jimhar8/WeatherMat/hardware/documentation/weatherSystem_blockDiagram.pdf

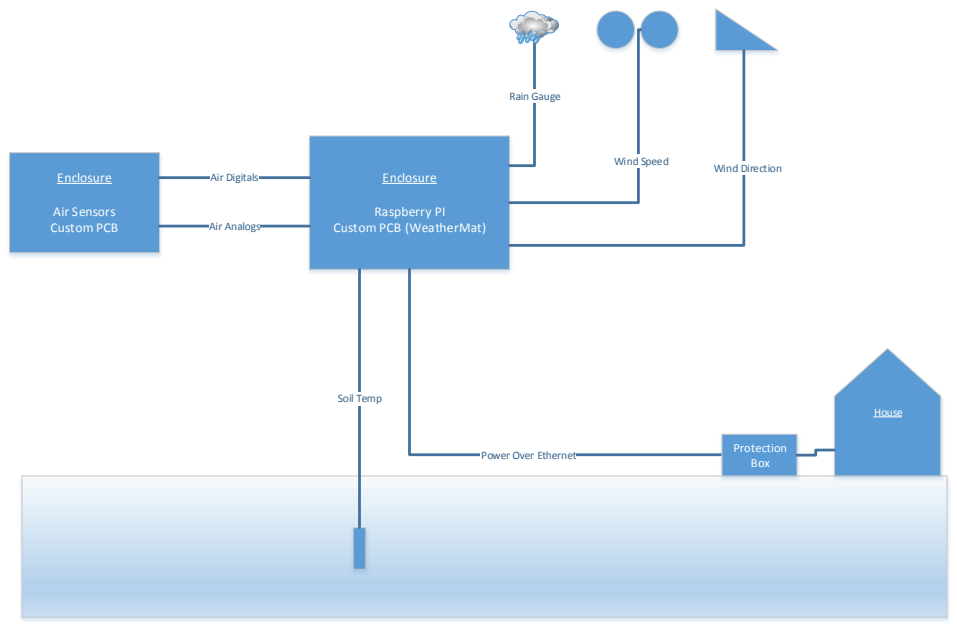
[picture p1: page 1]
Enclosure; Air Sensors Custom PCB; Air Digitals; Air Analogs; Wind Speed; Wind Direction; Soil Temp; Rain Gauge; House; Power Over Ethernet; Protection; Box

Raspberry PI
Custom PCB (WeatherMat)
