jimhar8/WeatherMat/hardware/documentation/airBoard_parts_top.pdf

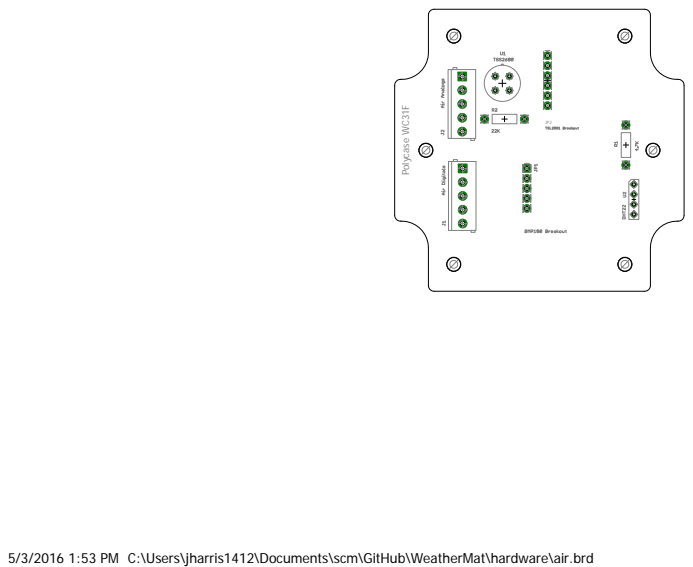
[picture p2: page 1]
Polycase WC31F

5/3/2016 1:53 PM C:\Users\jharris1412\Documents\scm\GitHub\WeatherMat\hardware\air.brd
