jimhar8/WeatherMat/hardware/documentation/airBoard_schematic.pdf

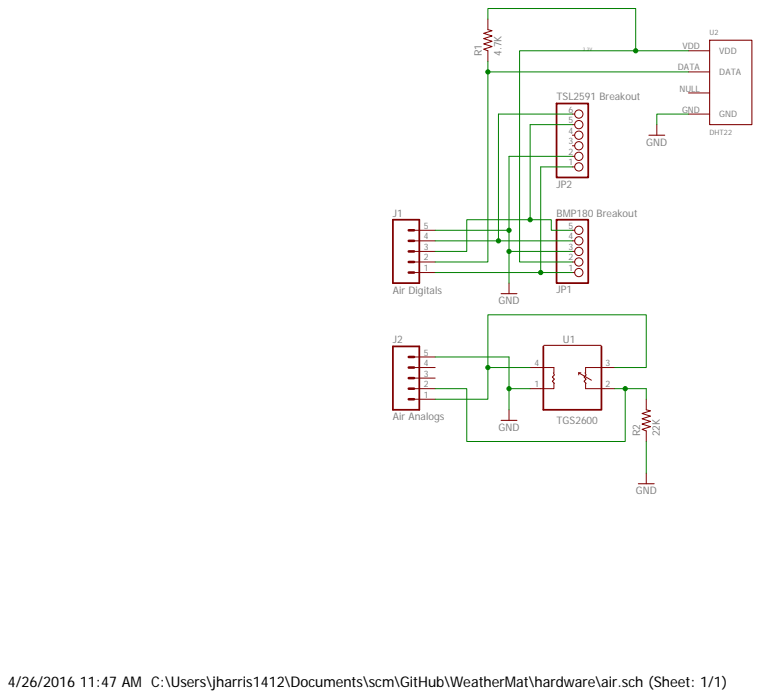
[picture p3: page 1]

4/26/2016 11:47 AM C:\Users\jharris1412\Documents\scm\GitHub\WeatherMat\hardware\air.sch (Sheet: 1/1)
