jimhar8/WeatherMat/hardware/documentation/weatherMat_parts_top.pdf

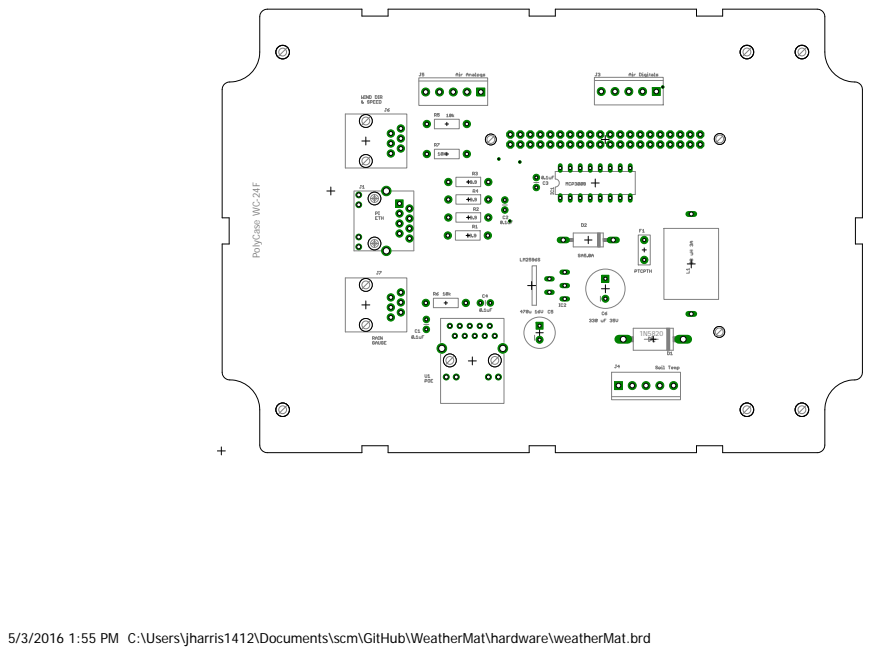
[picture p4: page 1]
PolyCase WC-24F

5/3/2016 1:55 PM C:\Users\jharris1412\Documents\scm\GitHub\WeatherMat\hardware\weatherMat.brd
