jimhar8/WeatherMat/hardware/documentation/weatherMat_schematic.pdf

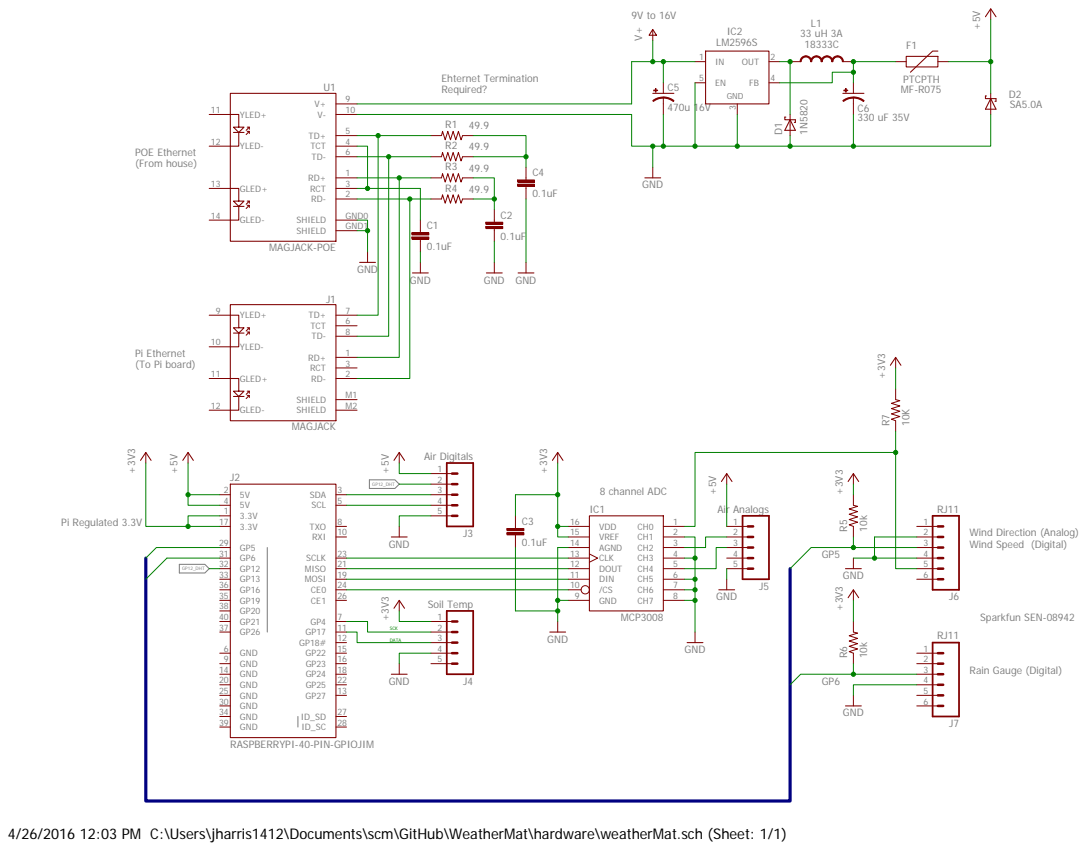
[picture p5: page 1]

4/26/2016 12:03 PM C:\Users\jharris1412\Documents\scm\GitHub\WeatherMat\hardware\weatherMat.sch (Sheet: 1/1)
