jimhar8/WeatherMat/hardware/air.brd

## EAGLE design hardware/air.brd (2016-05-23)

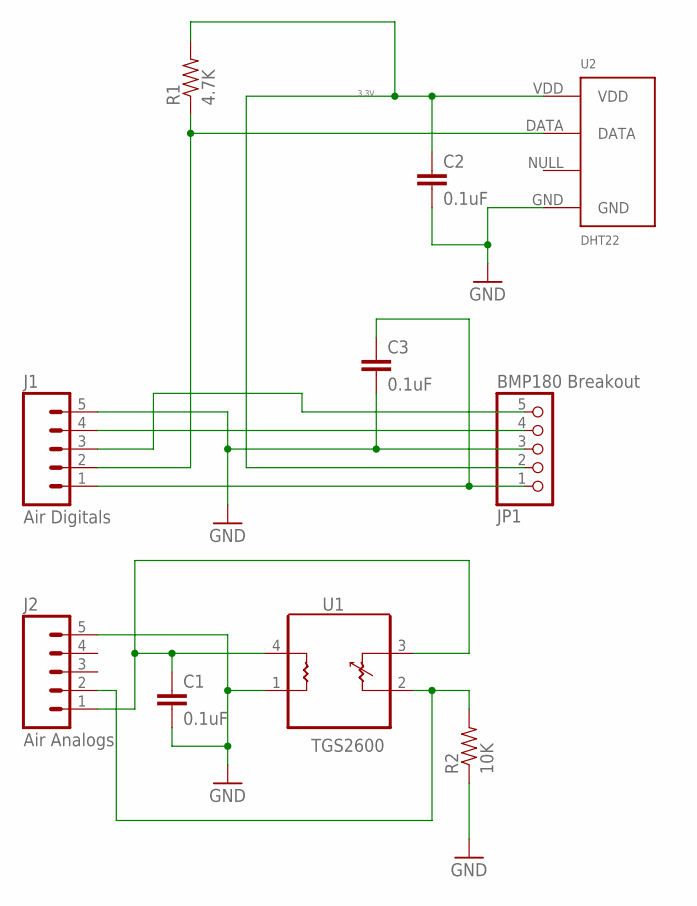
[picture p6: schematic air.sch]

Parts:
C1, C2, C3: 0.1uF; CAP-PTH-SMALL
J1: Air Digitals; SCREWTERMINAL-3.5MM-5
J2: Air Analogs; SCREWTERMINAL-3.5MM-5
JP1: BMP180 Breakout; 1X05_ROUND_70
R1: 4.7K; AXIAL-0.4
R2: 10K; AXIAL-0.4
U1: TGS2600; TO5_AIRQ
U2: DHT22; AM2302

Connections:
3.3V: C2.1, JP1.2, R1.P$2 (2), U2.VDD
GND: C1.2, C2.2, C3.2, J1.5, J2.5, JP1.3, R2.P$1 (1), U1.1, U2.GND
unnamed: C3.1, J1.1, JP1.1
unnamed: J1.4, JP1.4
unnamed: J1.2, R1.P$1 (1), U2.DATA
unnamed: J2.2, R2.P$2 (2), U1.2
unnamed: C1.1, J2.1, U1.3, U1.4
SDA: J1.3, JP1.5

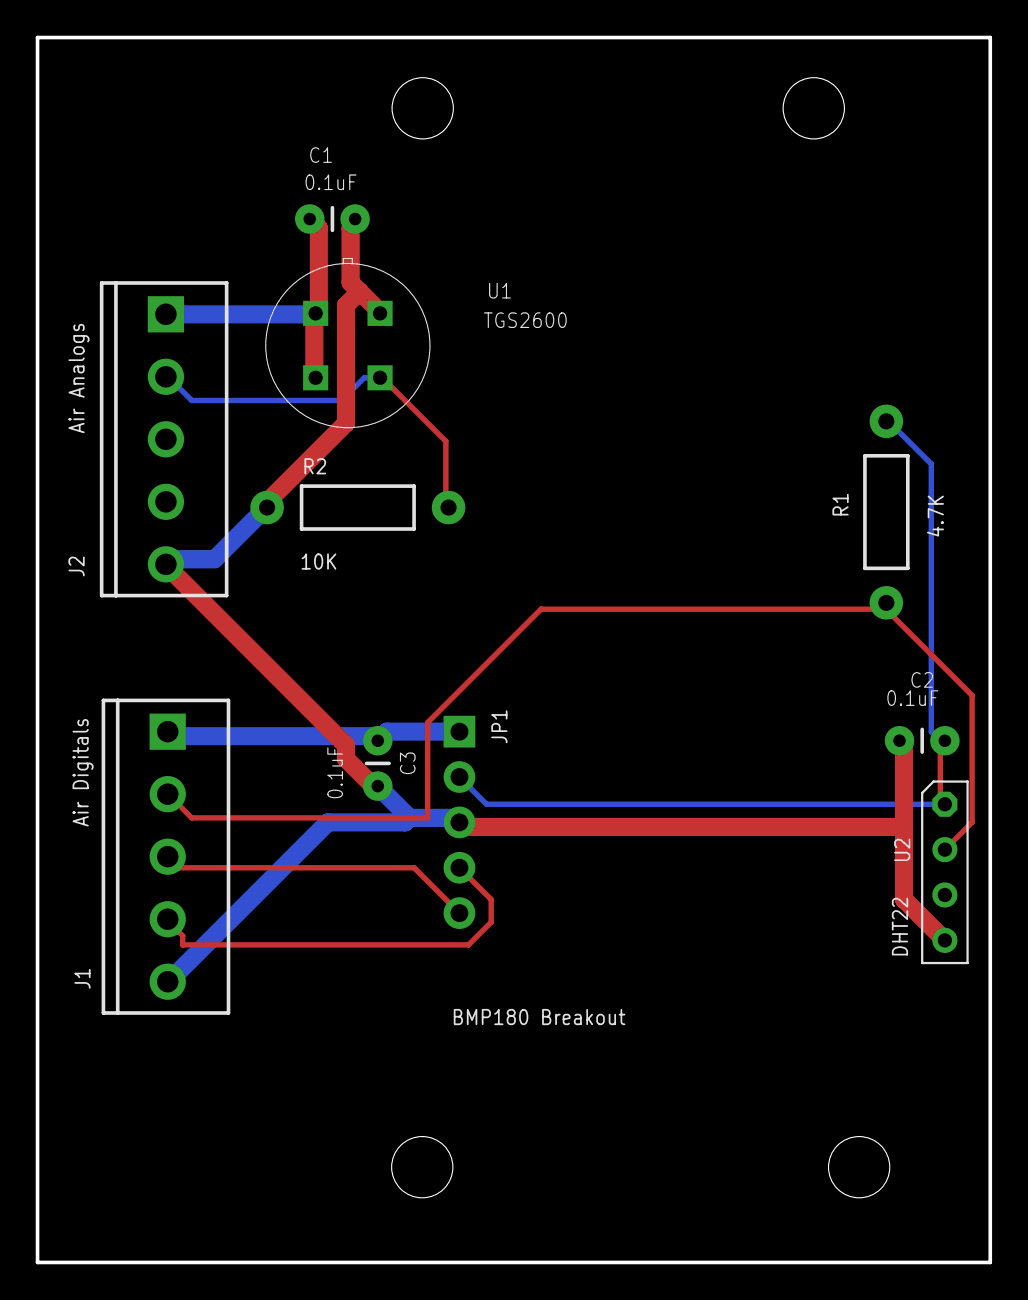
[picture p7: board air.brd from above]

Board: 2 copper layers, 53.3 x 68.6 mm, 10 parts (0 on the bottom side), 8 nets.
