jimhar8/WeatherMat/hardware/weatherMat.brd

## EAGLE design hardware/weatherMat.brd (2016-03-20)

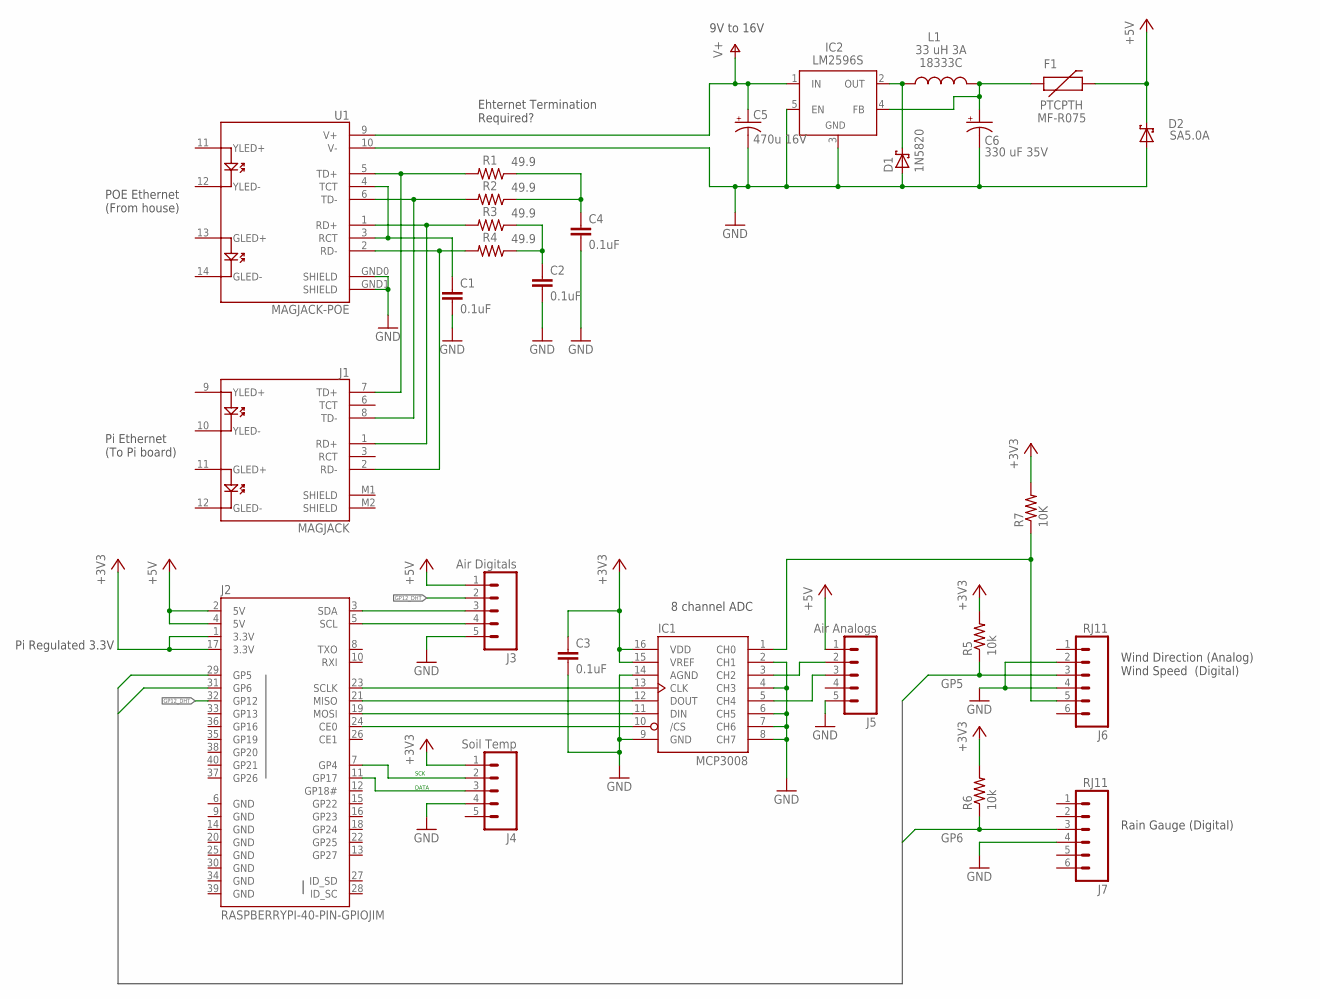
[picture p8: schematic weatherMat.sch]

Parts:
C1, C2, C3, C4: 0.1uF; CAP-PTH-SMALL
C5: 470u 16V; CPOL-RADIAL-470UF-16V
C6: 330 uF 35V; CPOL-RADIAL-100UF-25V
D1: 1N5820; DO201T15
D2: SA5.0A; DO15-12
F1: PTCPTH; PTC; PARTNUM MF-R075
IC1: MCP3008; DIL16
IC2: LM2596S; TO220-51
J1: MAGJACK
J2: RASPBERRYPI-40-PIN-GPIOJIM; 2X20-JIM
J3: Air Digitals; SCREWTERMINAL-3.5MM-5
J4: Soil Temp; SCREWTERMINAL-3.5MM-5
J5: Air Analogs; SCREWTERMINAL-3.5MM-5
J6, J7: RJ11; RJ11-6
L1: 33 uH 3A; MURATA; PARTNUM 18333C
R1, R2, R3, R4: 49.9; AXIAL-0.4
R5, R6: 10k; AXIAL-0.4
R7: 10K; AXIAL-0.4
U1: MAGJACK-POE

Connections:
+3V3: C3.1, IC1.15 (VREF), IC1.16 (VDD), J2.1 (3.3V), J2.17 (3.3V), J4.1, R5.P$2 (2), R6.P$2 (2), R7.P$2 (2)
+5V: D2.C, F1.P$2 (2), J2.2 (5V), J2.4 (5V), J3.1, J5.1
GND: C1.2, C2.2, C3.2, C4.2, C5.2 (-), C6.2 (-), D1.A, D2.A, IC1.2 (CH1), IC1.4 (CH3), IC1.6 (CH5), IC1.7 (CH6), IC1.8 (CH7), IC1.9 (GND), IC1.14 (AGND), IC2.3 (GND), IC2.5 (EN), J2.6 (GND), J2.9 (GND), J2.14 (GND), J2.20 (GND), J2.25 (GND), J2.30 (GND), J2.34 (GND), J2.39 (GND), J3.5, J4.4, J5.5, J6.2, J6.4, J7.4, U1.10 (V-), U1.GND0 (SHIELD), U1.GND1 (SHIELD)
GP5: J2.29 (GP5), J6.3, R5.P$1 (1)
GP6: J2.31 (GP6), J7.3, R6.P$1 (1)
GP12_DHT: J2.32 (GP12), J3.2
unnamed: D1.C, IC2.2 (OUT), L1.P$1 (1)
unnamed: C1.1, U1.3 (RCT), U1.4 (TCT)
unnamed: J1.7 (TD+), R1.P$2 (2), U1.5 (TD+)
unnamed: J1.8 (TD-), R2.P$2 (2), U1.6 (TD-)
unnamed: J1.1 (RD+), R3.P$2 (2), U1.1 (RD+)
unnamed: J1.2 (RD-), R4.P$2 (2), U1.2 (RD-)
unnamed: C4.1, R1.P$1 (1), R2.P$1 (1)
unnamed: C2.1, R3.P$1 (1), R4.P$1 (1)
unnamed: IC1.12 (DOUT), J2.21 (MISO)
unnamed: IC1.11 (DIN), J2.19 (MOSI)
unnamed: IC1.13 (CLK), J2.23 (SCLK)
unnamed: IC1.10 (/CS), J2.24 (CE0)
unnamed: IC1.1 (CH0), J6.5, R7.P$1 (1)
unnamed: C6.1 (+), F1.P$1 (1), IC2.4 (FB), L1.P$3 (2)
unnamed: J2.3 (SDA), J3.3
unnamed: J2.5 (SCL), J3.4
unnamed: IC1.3 (CH2), J5.2
unnamed: IC1.5 (CH4), J5.3
unnamed: J2.11 (GP17), J4.3
unnamed: J2.7 (GP4), J4.2
V+: C5.1 (+), IC2.1 (IN), U1.9 (V+)

Notes on the sheet:
Wind Direction (Analog) Wind Speed (Digital)
Rain Gauge (Digital)
POE Ethernet (From house)
Pi Ethernet (To Pi board)
Pi Regulated 3.3V
9V to 16V
DATA
SCK
Ehternet Termination Required?
8 channel ADC

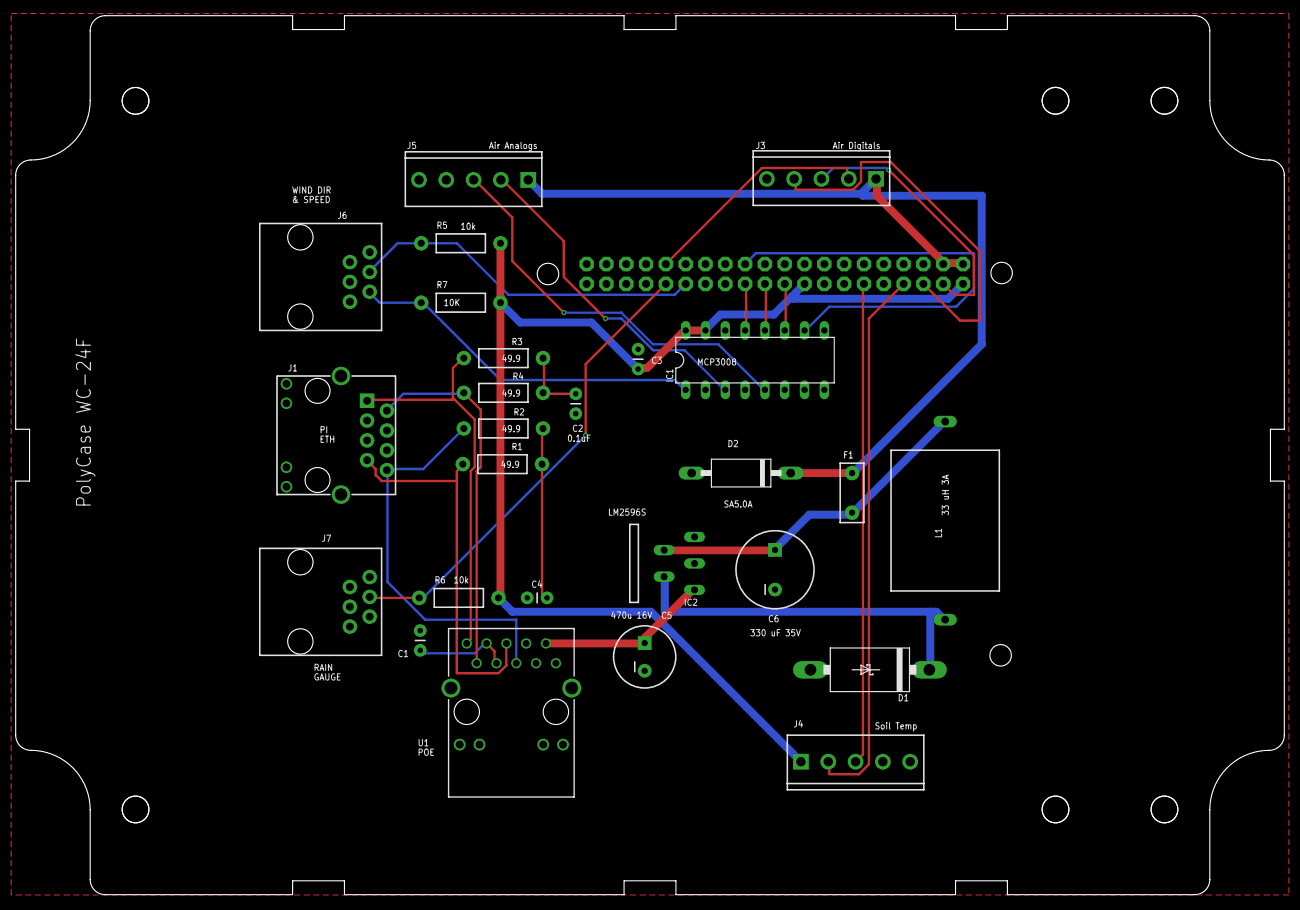
[picture p9: board weatherMat.brd from above]

Board: 2 copper layers, 162.7 x 112.7 mm, 28 parts (1 on the bottom side), 27 nets.

Other parts of the board:
U$2: WC-24F
