jimhar8/WeatherMat/software/WeatherMat_common/scheduler.lua

local pending = {}

local function sort_by_time(array)
	table.sort(array, function(e1, e2)
							return e1.time < e2.time
					  end)
end

local function wait(seconds)
	coroutine.yield(seconds)
end

local function remove_first(array)

	result = array[1]
	array[1] = array[#array]
	array[#array] = nil

	return result

end


local function schedule(time, action)
	pending[#pending + 1 ] = {
		time = time,
		action = action
	}

	sort_by_time(pending)
end


local function run()
	while #pending > 0 do
		while os.clock() < pending[1].time do end -- bus -wait

		local item = remove_first(pending)
		local _ , seconds = coroutine.resume(item.action)

		if seconds then
			later = os.clock() + seconds
			schedule(later, item.action)
		end
	end
end


return {
	schedule = schedule,
	run = run,
	wait = wait
}
