jimhar8/WeatherMat/software/WeatherMat_common/test_scheduler.lua

scheduler = require('scheduler')


function punch()
	for i = 1, 5 do
		print('check wind speed ' .. i)
		scheduler.wait(1.0)
	end
end

function block()
	for i = 1, 5 do
		print('check rain gauge ' .. i)
		scheduler.wait(2.0)
	end
end

scheduler.schedule(0.0, coroutine.create(punch))
scheduler.schedule(0.0, coroutine.create(block))

scheduler.run()
