jimhar8/WeatherMat/(commit log)

2016-03-01 remove stuff
    [Raspberry-Pi-B-Plus-V1.2-Mechanical.dxf, Raspberry-Pi-B-Plus-V1.2-Mechanical_Stripped.dxf, WC-23C+08.DWG, WC-23F+1508.DWG, WC-24C+08.DWG, WC-24F+1508.DWG, WC-31C+08.DWG, WC-31F+1508.DWG]
2016-03-03 Push gerbers
    [weatherMat.GBL, weatherMat.GBO, weatherMat.GBS, weatherMat.GTL, weatherMat.GTO, weatherMat.GTP, weatherMat.GTS]
2016-03-03 Added air board stuff
    [air.brd, air.sch]
2016-03-11 Board update
    [weatherMat.brd]
2016-03-11 Gerber updates
    [weatherMat.GBL, weatherMat.GBS, weatherMat.GTL, weatherMat.GTO, weatherMat.GTS]
2016-03-17 Wind calculations and script
    [WindDir.xlsx]
2016-03-20 board updates
    [air.sch, weatherMat.brd, weatherMat.sch]
2016-03-25 Rename dirs
    [WindDir.xlsx]
2016-04-02 eagle updates
    [air.brd, air.sch]
2016-04-30 soil sensor updates
2016-05-06 remove light sensor from air board
    [air.brd, air.sch]
2016-05-06 Revise for Ambient Weather SRS100
    [air.brd]
2016-05-14 decoupling caps
    [air.brd, air.sch]
